Shiro-01/IMU-Kalman-filter-on-an-FPGA-with-High-level-Synthesis/docs/Literature/KalmanFilter/image.png

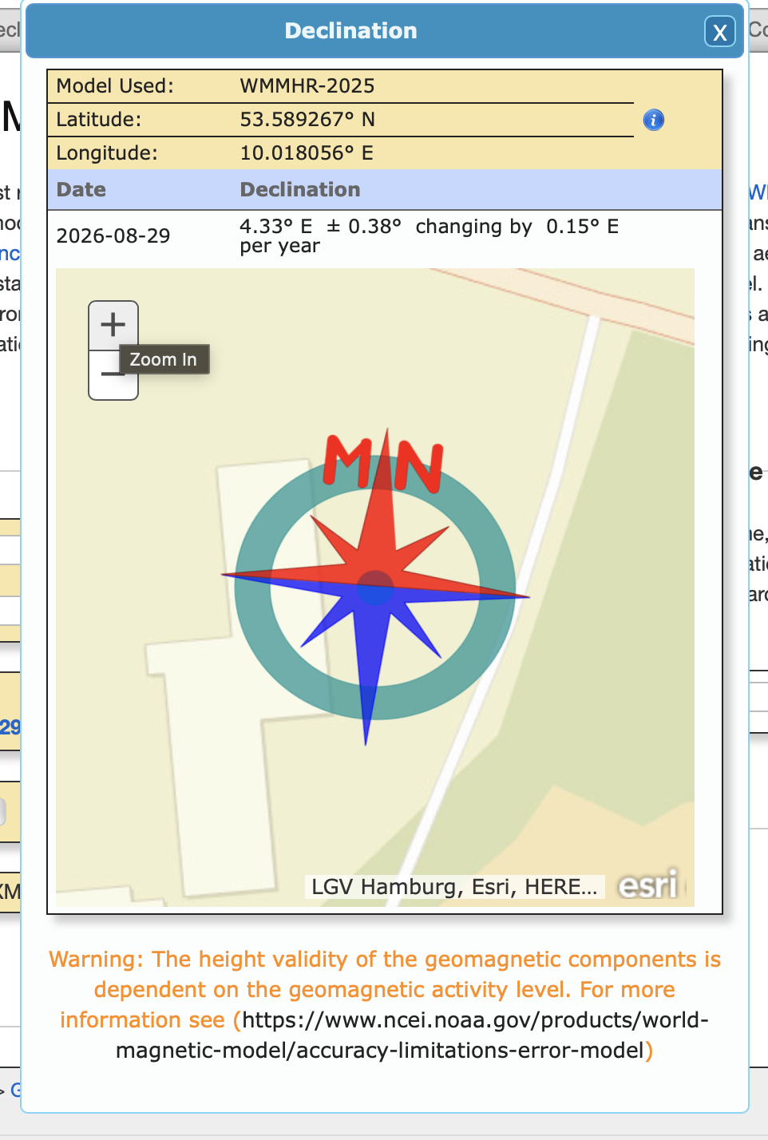
docs/Literature/KalmanFilter/image.png
