Shiro-01/IMU-Kalman-filter-on-an-FPGA-with-High-level-Synthesis/host/imu_pipeline/app_mode0.py

""""
 * @file    app_mode0.py
 * @brief   This app uses the sample_converter and uart_reader to parse & convert the IMU data
 *          comming from the FPGA through UART Protocol to a physical data. then get prepared to KF by data_preparer class then
 *          goes to EKF that predicts our eular angles
 *
 *
 * @author  Abdelrahman Hewala
 * @note    Supervisor: Prof. Lutz Leutelt
 * @date    2026
"""
import serial 
from sample_converter import SampleConverter
import sys
from uart_reader import read_packet
from typing import List
from data_preparer import DataPreparer
from frame_types import PhysicalSampleMode0
from ekf import EKF #, EKFResult
import numpy as np

# Constants 
ACC_LSB_PER_1_G  = 2048.0             # LSBs/g.   - ±16g
GYRO_LSB_PER_DPS = 16.4            # LSBs/(dps) - ±2000dps
MAG_LSB = 0.15                      # µT/LSB, fixed per AK09916 spec
TIMESTAMP_CLK_FREQ = 100_000_000.0    # in Hz
TEMP_LSB_PER_C =  333.87
TEMP_OFFSET = 21.0

MAG_FIELD_HORIZONZAL_MT = 18.225       #micro Tesla
MAG_FIELD_VERTICAL_MT = 46.710  
TOTAL_MAG_FIELD = 50.134
# UART Protocol Setting CONSTANTS 
PORT     = '/dev/tty.usbserial-210183ACB00B1'                                      #'/dev/tty.usbserial-10' for MAC    # change it to whatever it apears in ur machine. try command (grep ('.*usb.*' | '.*USB.*') /dev) in ur terminal to see the nammings
BAUDRATE = 1152000
PARITY   = serial.PARITY_NONE      # serial.PARITY_NONE
STOPBITS = serial.STOPBITS_ONE    # erial.STOPBITS_ONE
BYTESIZE = serial.EIGHTBITS

# Caliberation data
HARD_IRON_OFFSET = [
        -19.217160917473784,
        4.6818916120275045,
        21.884958232062306
    ]

SOFT_IRON_MATRIX = [
        [
            3.0235188914992976,
            0.0010402698374350487,
            -0.010193342182927558
        ],
        [
            0.0010402698374350388,
            2.888793521690507,
            -0.13287755465078732
        ],
        [
            -0.010193342182927482,
            -0.1328775546507872,
            3.0989181093312315
        ]
    ]


"""  [
        -20.630925763235247,
        -26.758929290697434,
        -15.01591010444599
    ]

[[
            1.2602460240169397,
            -0.00027246814520328244,
            -0.011502889440097546
        ],
        [
            -0.00027246814520323116,
            1.2836736293024409,
            -0.06755421411462412
        ],
        [
            -0.011502889440097551,
            -0.06755421411462412,
            1.262128244476128
        ]
    ] """
""" 
[
        -40.754632281233164,
        -34.64990225204457,
        -10.61477904191419
    ]

[[
            1.202253221404707,
            -0.000941668415174785,
            -0.0014377124871611845
        ],
        [
            -0.000941668415174805,
            1.229623754245405,
            -0.04198391249607547
        ],
        [
            -0.0014377124871612235,
            -0.041983912496075554,
            1.1698975996811463
        ]
    ]
 """


""" [
        -41.89502344297138,
        -28.832289599630325,
        -10.91756907457918
    ]


[
        [
            1.268799262964437,
            -0.001760949298995377,
            -0.033531314640759584
        ],
        [
            -0.0017609492989954598,
            1.263531055221906,
            -0.08825611039353842
        ],
        [
            -0.0335313146407597,
            -0.08825611039353852,
            1.1660441347290051
        ]
    ] """



""" 
H = [-42.779731, -33.839090, -7.471299] # uT
s=[ 1.27437908, -0.00194595,  0.01723701],
 [-0.00194595,  1.26077413, -0.03981259],
 [ 0.01723701, -0.03981259,  1.23319444]
 ]
 """


GYRO_ARW = [0.000134255, 0.000122338, 0.000129317]
GYRO_BI = [4.28161e-5, 4.02741e-05, 4.48088e-05]

ACCEL_DEV = [0.0625, 0.0625, 0.0625]
MAG_DEV = [0.5, 0.5, 0.5]

def main():
    try:
        ser = serial.Serial(
            port=PORT,
            baudrate=BAUDRATE,
            bytesize=BYTESIZE,
            parity=PARITY,
            stopbits=STOPBITS,
            timeout=1
        )
    except serial.SerialException as e:
        print(f"Could not open serial port {PORT}: {e}")
        print("Check that the FPGA is connected and the PORT constant matches your device.")
        print("Run: ls /dev/ | grep -i usb")
        sys.exit(1)

    # instantiateof the classes class
    sampleConverter = SampleConverter(ACC_LSB_PER_1_G, GYRO_LSB_PER_DPS, TIMESTAMP_CLK_FREQ, MAG_LSB, TEMP_LSB_PER_C, TEMP_OFFSET)
    datePreparer = DataPreparer(gyro_ARW = GYRO_ARW, hard_iron_offset=HARD_IRON_OFFSET, soft_iron_matrix=SOFT_IRON_MATRIX, mag_field_horizontal_uT =MAG_FIELD_HORIZONZAL_MT, mag_field_vertical_uT = MAG_FIELD_VERTICAL_MT)
    # first 100 smaples for preperation class initialize method
    samples_init_arr : List[PhysicalSampleMode0]  = []
    for i in range(1000) :
        result = read_packet(ser)
        if result is None:
            continue
        modeWord, samplesMode0 = result
        physicalSampleMode0_x = sampleConverter.convert(samplesMode0)
        samples_init_arr.append(physicalSampleMode0_x)

    # Initial state vector as np vector
    x0, p0 = datePreparer.initialize(samples_init_arr)

    ekf = EKF(
        x0 = x0,
        p0 = p0,
        gyro_ARW = GYRO_ARW,
        gyro_bias_instability = GYRO_BI,
        accel_dev = ACCEL_DEV,
        mag_dev   = MAG_DEV,
        mag_field_horizontal_uT = MAG_FIELD_HORIZONZAL_MT,
        mag_field_vertical_uT = MAG_FIELD_VERTICAL_MT
    )

    while True:
        result = read_packet(ser)
        if result is None:
            continue
        modeWord, samplesMode0 = result
        physicalSampleMode0_x = sampleConverter.convert(samplesMode0)
        preparedSample = datePreparer.prepare(physicalSampleMode0_x)
        ekf_result = ekf.step(preparedSample)
        print(np.array2string(ekf_result.X*180/np.pi, precision=2, floatmode='fixed', suppress_small=True), "\n")

        gyro_dps = np.array([physicalSampleMode0_x.gx, physicalSampleMode0_x.gy, physicalSampleMode0_x.gz]) * 180/np.pi
        print(np.array2string(gyro_dps, precision=2, floatmode='fixed', suppress_small=True), "\n")        
        # print(physicalSampleMode0_x.az, "\n")        
        # print(physicalSampleMode0_x.ay, "\n")        
        # print(physicalSampleMode0_x.ax, "\n")     

        print(physicalSampleMode0_x.mx, "\n")        
        print(physicalSampleMode0_x.my, "\n")        
        print(physicalSampleMode0_x.mz, "\n")  

        print(preparedSample.mx, "\n")        
        print(preparedSample.my, "\n")        
        print(preparedSample.mz, "\n")           


        mb = np.array(SOFT_IRON_MATRIX) @ (np.array([physicalSampleMode0_x.mx, physicalSampleMode0_x.my, physicalSampleMode0_x.mz]) - np.array(HARD_IRON_OFFSET))
        print(mb, np.linalg.norm(mb))

if __name__ == "__main__":
    main()
