Shiro-01/IMU-Kalman-filter-on-an-FPGA-with-High-level-Synthesis/FPGA/IP_repo/ekf/hdl/verilog/ekf_mul_28ns_29ns_57_2_1.v

// 67d7842dbbe25473c3c32b93c0da8047785f30d78e8a024de1b57352245f9689

`timescale 1 ns / 1 ps

 (* DowngradeIPIdentifiedWarnings="yes" *) module ekf_mul_28ns_29ns_57_2_1(clk,ce,reset,din0, din1, dout);
parameter ID = 1;
parameter NUM_STAGE = 0;
parameter din0_WIDTH = 14;
parameter din1_WIDTH = 12;
parameter dout_WIDTH = 26;

input clk;
input ce;
input reset;

input [din0_WIDTH - 1 : 0] din0; 
input [din1_WIDTH - 1 : 0] din1; 
output [dout_WIDTH - 1 : 0] dout;

wire signed [dout_WIDTH - 1 : 0] tmp_product;


reg signed [dout_WIDTH - 1 : 0] buff0;























assign tmp_product = $signed({1'b0, din0}) * $signed({1'b0, din1});









always @(posedge clk)
begin
    if (ce) begin
        buff0 <= tmp_product;



















    end
end




assign dout = buff0;




















endmodule
