Shiro-01/IMU-Kalman-filter-on-an-FPGA-with-High-level-Synthesis/FPGA/IP_repo/ekf/hdl/vhdl/ekf_mul_15ns_13s_28_1_1.vhd

-- 67d7842dbbe25473c3c32b93c0da8047785f30d78e8a024de1b57352245f9689
library IEEE;
use IEEE.std_logic_1164.all;
use IEEE.numeric_std.all;


entity ekf_mul_15ns_13s_28_1_1 is
generic (
    ID : INTEGER := 1;
    NUM_STAGE : INTEGER := 0;
    din0_WIDTH : INTEGER := 14;
    din1_WIDTH : INTEGER := 12;
    dout_WIDTH : INTEGER := 26);
port (

    din0: in std_logic_vector(din0_WIDTH - 1 downto 0);
    din1: in std_logic_vector(din1_WIDTH - 1 downto 0);
    dout: out std_logic_vector(dout_WIDTH - 1 downto 0));


end entity;

architecture behav of ekf_mul_15ns_13s_28_1_1 is
attribute DowngradeIPIdentifiedWarnings : string;
attribute DowngradeIPIdentifiedWarnings of behav: architecture is "yes";
    signal tmp_product : std_logic_vector(dout_WIDTH - 1 downto 0);
    signal a_i : std_logic_vector(din0_WIDTH - 1 downto 0);
    signal b_i : std_logic_vector(din1_WIDTH - 1 downto 0);
    
    
    
    
    
    
    
    
    
    
        
        
        
        
        
        
        
        
        
              
begin
    a_i <= din0;
    b_i <= din1;




    tmp_product <= std_logic_vector(resize(unsigned(std_logic_vector(signed('0' & a_i) * signed(b_i))), dout_WIDTH));








    dout <= tmp_product;























end architecture;
