Shiro-01/IMU-Kalman-filter-on-an-FPGA-with-High-level-Synthesis/(commit log)

2026-07-28 updating ICM Driver to enable Mag Measurements
2026-07-28 new ICM Driver with Mag enabled and configured
2026-07-28 Delete Code/ESP32/ESP32_SensorFusion+Streaming directory
    duplicated Directory
2026-07-29 adding UART Configuration to match ESP's
2026-07-29 UART Stream Driver
2026-08-03 Commiting AXI STEAM UART module
2026-08-03 Fixing Parity bit bug on the Reciever side
    [AXI_STREAM_UART.vhd]
2026-08-03 packing UART IP
2026-08-15 adding spi master source code and tb
2026-08-18 final SPI master IP, packed and Tested
2026-08-18 adding the first revision of SPI controller there could be still potential bug in the Running FSM
    [SPI_CONTROLLER.vhd]
2026-08-18 adding final uart controller IP with sim, tb, not yet packed to vivado
2026-08-19 spi controller bugs fixed
    [SPI_CONTROLLER.vhd]
2026-08-19 final spi controller
2026-08-19 spi controller tb
2026-08-19 adding final spi contoller + sim
2026-08-20 Packing UART Controller IP
2026-08-20 fixing the SPI Failure Flag Bug
    [SPI_CONTROLLER.vhd]
2026-08-20 Updating SPI Controller IP xml file
2026-08-20 Untrack embedded Kalman-and-Bayesian-Filters-in-Python repo
2026-08-20 moving Allen variance PC set up into ESP32 Folder
2026-08-20 adding imu_streaming Block Design
2026-08-20 spi controller readme.md
2026-08-21 adding product guide PDF to the SPI master IP
2026-08-23 moving phyical sample class from the converter class to the Frame types Class
2026-08-26 Add magnetometer_calibration as a submodule
2026-08-29 fixing issues with the final applicaiton
    [app.py]
2026-08-29 aligning the sensor axis to the body frame
2026-10-14 reorganising the repo. All PC programs are now under the host directory. inside the calibration that holds allan logger, allan dashbaord. mag logger, and mag calibration. esp32. is the pc set up from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
2026-10-14 updating the uart mode to mode 1
2026-10-14 adding additional checks/reads for the imu step up to avoid any stalls
2026-10-14 adding gambal lock pin
2026-10-14 Finish repo reorganisation: host/, firmware/ and .gitignore
    host/:
    - Move the remaining PC tools from Code/PCSetup into host/
    (imu_pipeline, calibration, esp32_benchmark)
    - Rename typo'd folders/files: allan_varriance -> allan_variance,
    AnalyizerDashboard -> analyzer_dashboard, dashboardV2.py -> dashboard.py,
    data_engine_V2.py -> data_engine.py
    - Resolve data/output paths relative to each script instead of the cwd
    (decoder.py, allan_logger.py, mag_calibration_logger.py)
    - Update stale references to old file names in docstrings and READMEs
    - Add host/README.md
    firmware/:
    - Move ESP32 sketches from Code/ESP32 to firmware/esp32 and rename them so
    each .ino matches its folder: imu_ben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
2026-10-14 Update READMEs for the new layout; document GHDL/GTKWave
    - Rewrite the root README: system overview diagram, current repository
    structure, getting started per component, project phases, status table,
    tools. Keep the WBS diagram and fix its broken code fence.
    - Add FPGA/hls/README.md: top function and interfaces, per-sample flow,
    output frame, files, constants, testbenches, how to rebuild the IP.
    - requirements.txt: note GHDL and GTKWave (system tools, not pip packages)
    with install commands.
2026-10-15 Update FPGA README for the EKF design and new layout
    - Describe the full IMU_ekf design (acquisition + HLS EKF IP, MODE 1 output)
    instead of the acquisition-only pipeline
    - Update structure and build steps: scripts/create_project.tcl, project
    imu_ekf, IMU_ekf.tcl, streaming.xdc
    - Add pin assignment and IP core tables, and GHDL/GTKWave simulation steps
    - Point the PC-side decoding to host/imu_pipeline; drop the outdated
    Code/PCsetup section and the "MODE_1 not implemented" limitation
